sergioacg/MPA-EIA/(commit log)

2026-10-07 MPA-EIA: manual, firmware v2, enlace serial y guiones de identificación
2026-10-21 Modelo de ensayos: arranca sin calibración; paso fijo 0.02
